henriqueedu2001/causp-lock-esp32/imgs/CHECK_IN.png

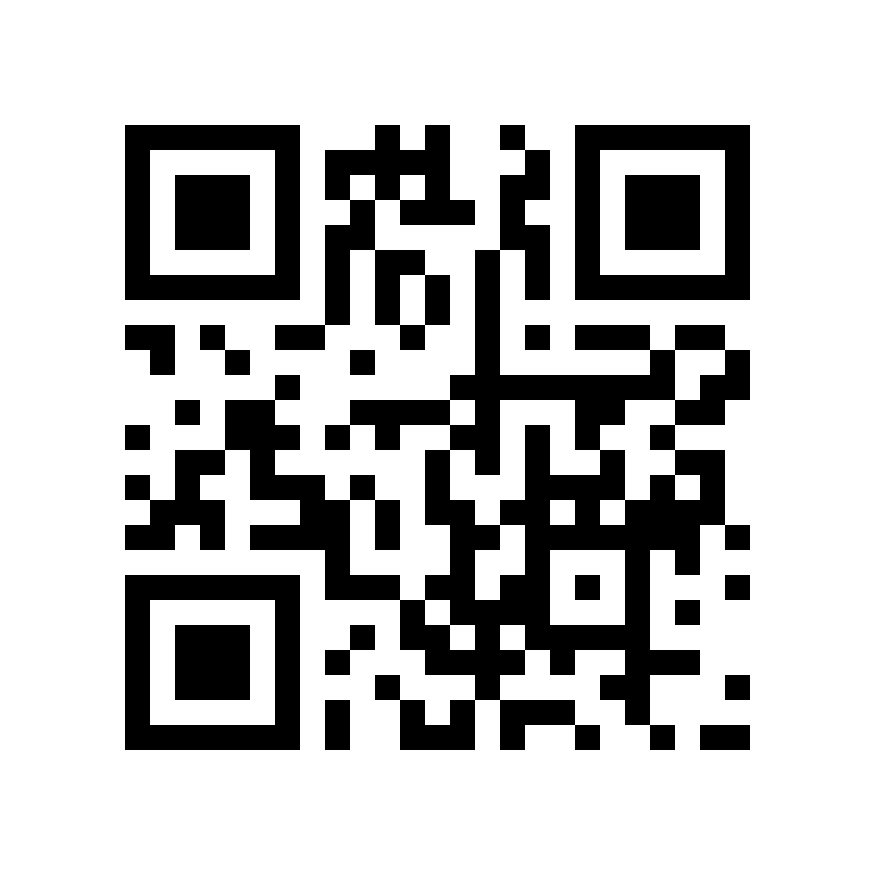
imgs/CHECK_IN.png
