henriqueedu2001/causp-lock-esp32/src/auth.h

#include "mbedtls/md.h"

#define KEY_LENGTH 20 

bool validateMessage(uint8_t *message, uint8_t *hash, int messageLength, uint8_t messageType);
void getHMAC_SHA1(
  const uint8_t *key,
  int key_length,
  const uint8_t *message,
  int message_length,
  uint8_t *output_hmac
);
bool validateSignature(uint8_t *informedHash, uint8_t *computedHash);
void printHMACSHA1(uint8_t *hash);
